Gabrielstoppa18/UFCAT-Self-Balancing-Cube/Materiais do cubo.xlsx

Sheet: Componentes eletrônicos
Componentes | Quantidade
Arduino nano | 1
Fonte 12v 2A | 1
Jack fêmea p/ fonte | 1
Jumper macho modificado | 20
Jumper macho/fêmea | 10
Motor Nidec 24h | 3
MPU6050 | 1
Protoboard 170 pontos | 1

Sheet: Componentes mecânicos
Componentes | Quantidade
Parafuso m4 | 66
Porcas m4 | 66
Parafuso m3 | 50
Porca m3 | 50

Sheet: Partes impressas
Componentes | Quantidade
Face externa para fixar motores (Peça 1) | 3
Face externa (Peça 2) | 3
Disco de Reação (Peça 3) | 3
Suporte do motor (Peça 4) | 3
Placa de suporte do circuito (Peça 9) | 1
Suporte para protoboard | 1
Suporte geral do circuito (Peça 5) | 1
Presilha para fixar as faces | 24
Suporte para prender circuito nas faces (Peça 6) | 3
Suporte para placa do circuito 1 (Peça 7) | 2
Suporte para placa do circuito 2 (Peça 8) | 1
