Gabrielstoppa18/UFCAT-Self-Balancing-Cube/peças 3D/6.stl

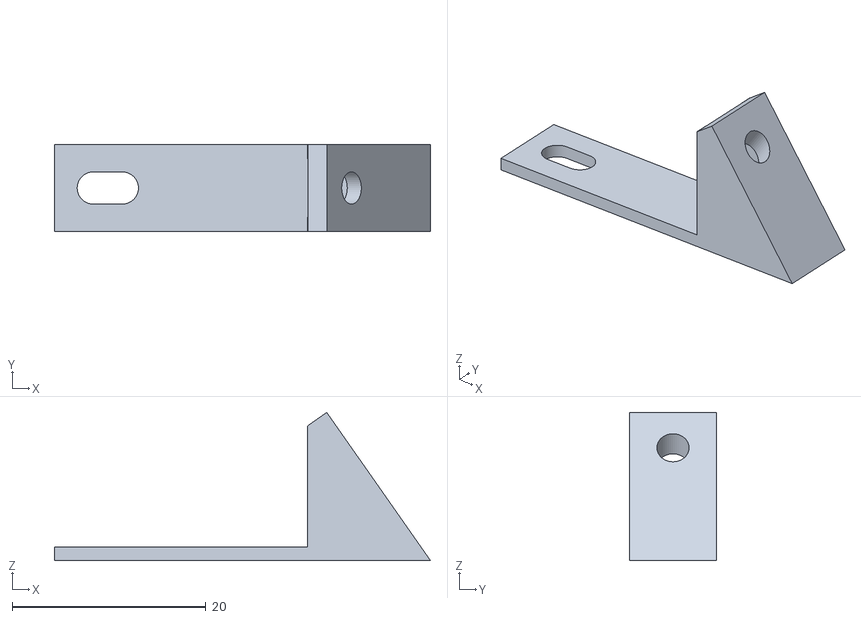
[picture p1: CAD file, 2023-03-07]
peças 3D/6.stl
38.8 x 9.00 x 15.3
