Gabrielstoppa18/UFCAT-Self-Balancing-Cube/peças 3D/Encaixe_protoboard.stl

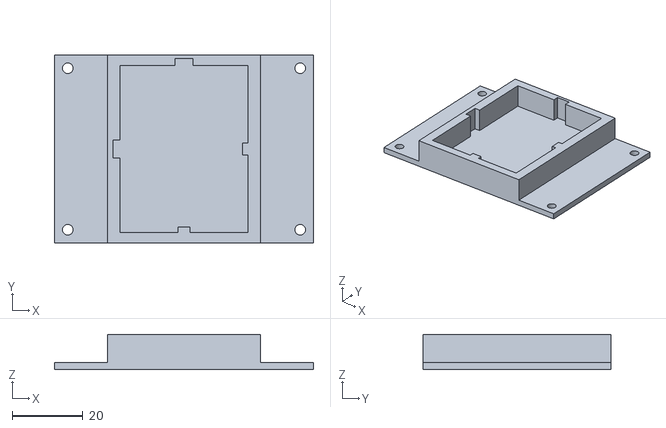
[picture p2: CAD file, 2023-03-07]
peças 3D/Encaixe_protoboard.stl
73.0 x 53.0 x 10.0
