Gabrielstoppa18/UFCAT-Self-Balancing-Cube/peças 3D/5.stl

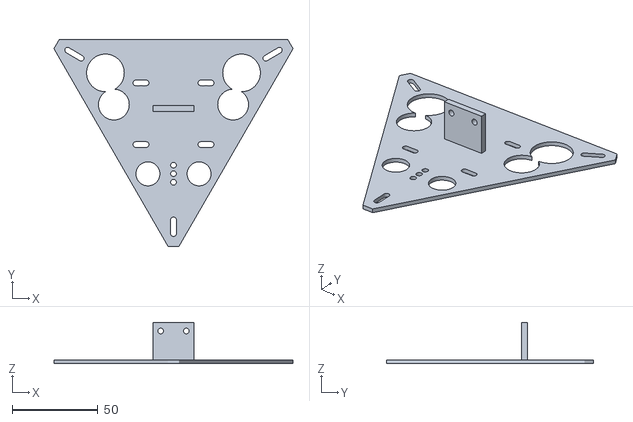
[picture p3: CAD file, 2023-03-07]
peças 3D/5.stl
139.6 x 120.8 x 24.0
