Gabrielstoppa18/UFCAT-Self-Balancing-Cube/peças 3D/4.stl

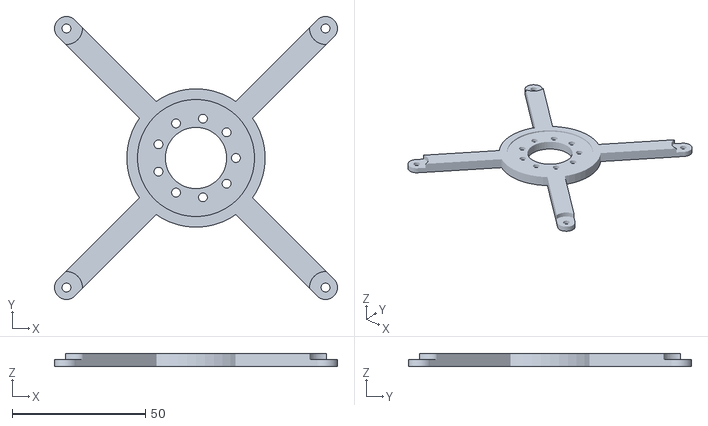
[picture p4: CAD file, 2023-03-07]
peças 3D/4.stl
106.3 x 106.3 x 5.00
