Gabrielstoppa18/UFCAT-Self-Balancing-Cube/peças 3D/2.stl

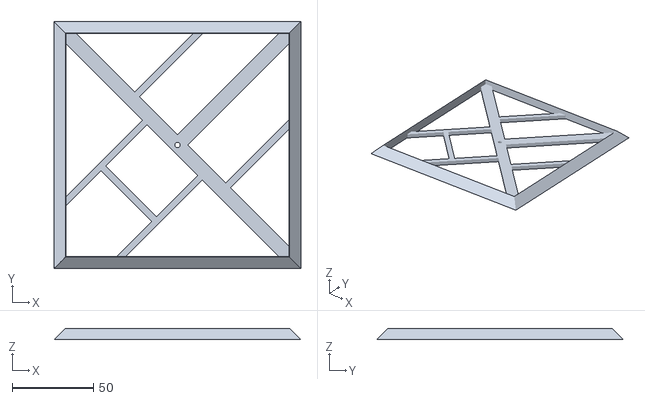
[picture p5: CAD file, 2023-03-07]
peças 3D/2.stl
152.0 x 152.0 x 7.00
