Gabrielstoppa18/UFCAT-Self-Balancing-Cube/peças 3D/8.stl

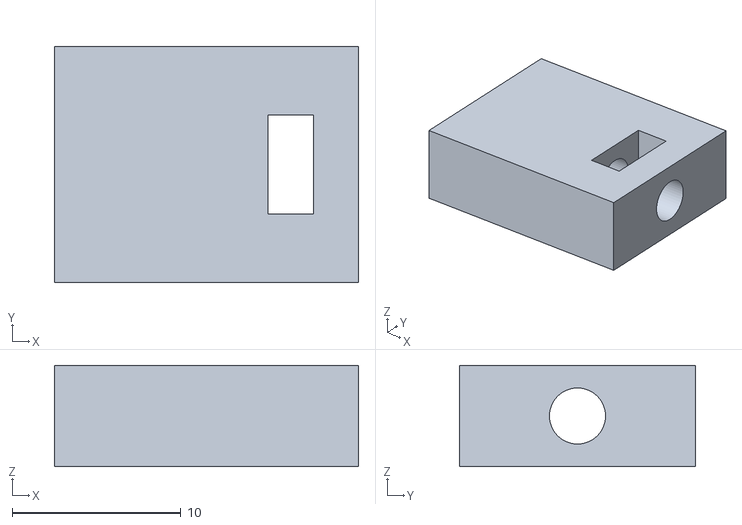
[picture p6: CAD file, 2023-03-07]
peças 3D/8.stl
18.0 x 14.0 x 6.00
