Gabrielstoppa18/UFCAT-Self-Balancing-Cube/peças 3D/9.stl

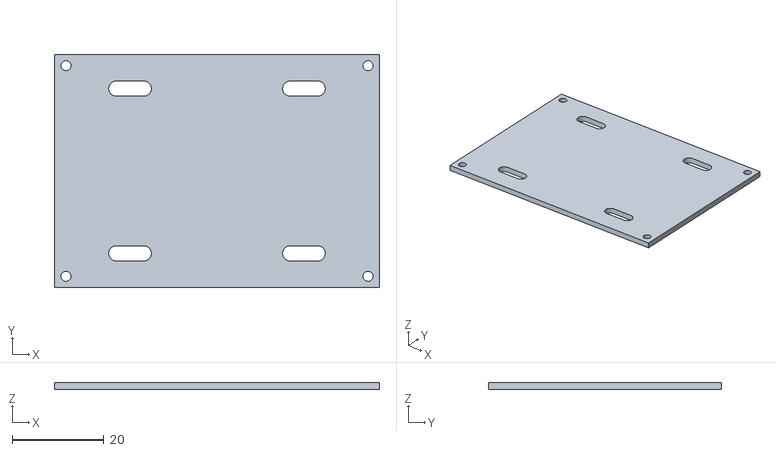
[picture p7: CAD file, 2023-03-07]
peças 3D/9.stl
71.0 x 51.0 x 1.60
