Gabrielstoppa18/UFCAT-Self-Balancing-Cube/peças 3D/3.stl

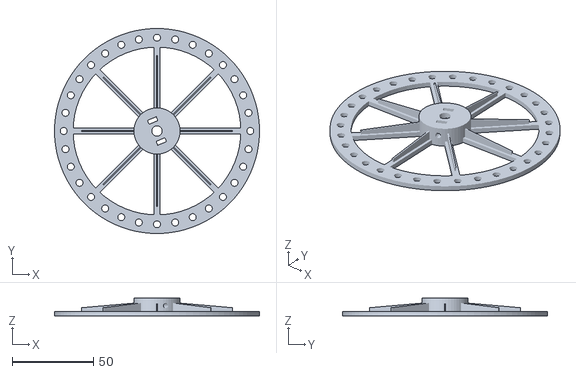
[picture p8: CAD file, 2023-03-07]
peças 3D/3.stl
126.4 x 126.4 x 11.0
