Gabrielstoppa18/UFCAT-Self-Balancing-Cube/peças 3D/7.stl

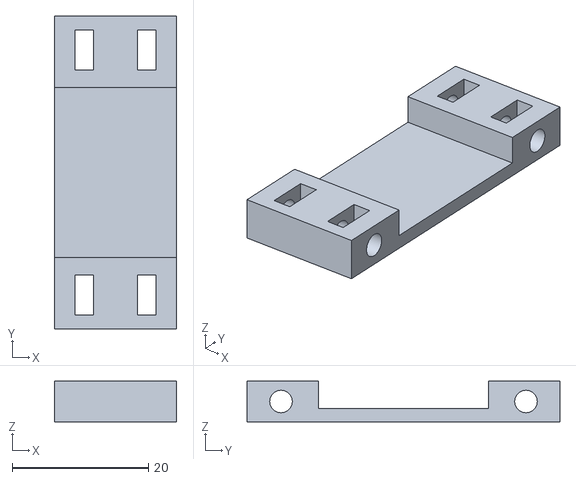
[picture p9: CAD file, 2023-03-07]
peças 3D/7.stl
18.0 x 46.0 x 6.00
