Gabrielstoppa18/UFCAT-Self-Balancing-Cube/peças 3D/conector_parede.STL

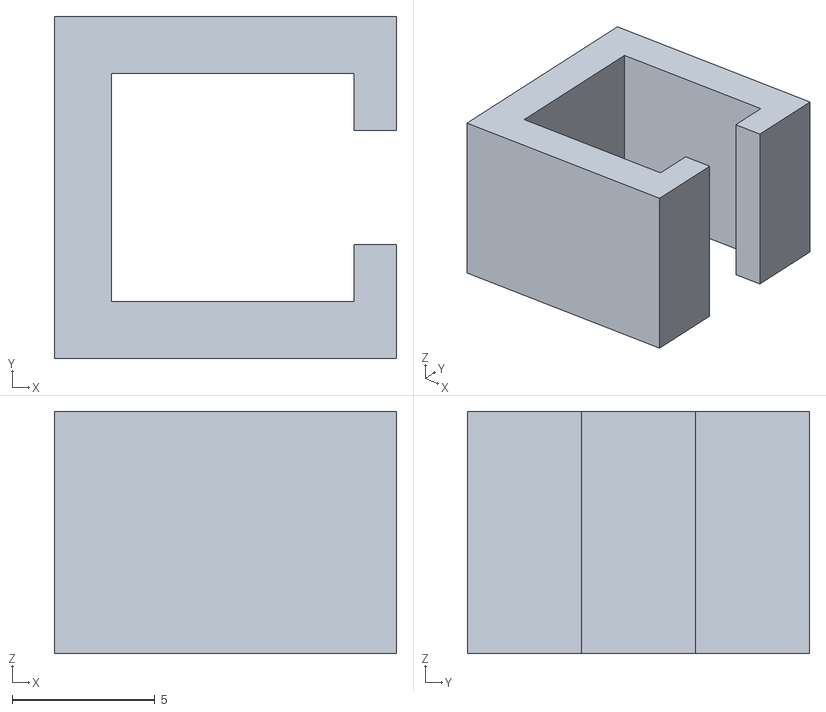
[picture p10: CAD file, 2023-03-07]
peças 3D/conector_parede.STL
12.0 x 12.0 x 8.50
