Gabrielstoppa18/UFCAT-Self-Balancing-Cube/peças 3D/1.stl

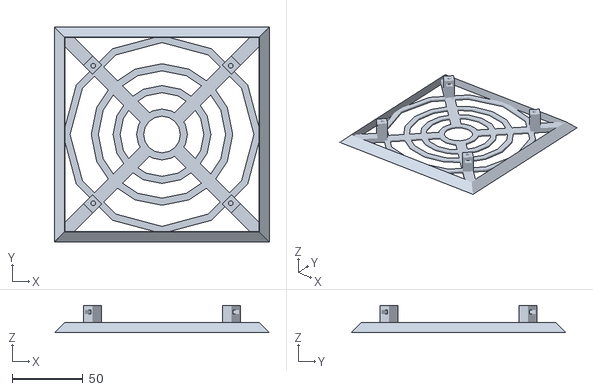
[picture p11: CAD file, 2023-03-07]
peças 3D/1.stl
152.0 x 152.0 x 19.3
